srampello/AUS_KIM/README.md

# AUS_KIM

> **Sitio del robot:** [srampello.github.io/AUS_KIM](https://srampello.github.io/AUS_KIM/) · [Ficha en RMP Robotics](https://srampello.github.io/RMP/robots/aus-kim/) · [Todos los robots](https://srampello.github.io/RMP/)

Robot de laberinto **AUS_KIM** de RMP. El repositorio conserva el firmware probado de la **V1 (ESP32-S3)** y documenta la nueva **V2 (ESP32-C3 Super Mini)**.

## AUS_KIM V2 — placa nueva ESP32-C3 (en desarrollo)

**Referencia completa:** [Hardware, pinout, alimentación, conectores y validaciones de AUS_KIM V2](docs/AUS_KIM_V2_ESP32-C3.md).

La V2 incorpora:
- **ESP32-C3 Super Mini** en lugar de ESP32-S3.
- **3 sensores Sharp GP2Y0E03**: un frontal, uno lateral izquierdo y uno lateral derecho (se retira un Sharp frontal).
- **1 sensor de piso QRE1113GR** en plaqueta externa de tres contactos para detectar la llegada.
- **2 motores N20 de 1500 RPM con encoders de cuadratura completos** (dos canales A/B por motor).
- **DRV8833** con jumper JP1 en EEP/nSLEEP para habilitar los motores después del arranque.
- **Pulsador físico START** en GPIO9/BOOT, con pull-up; resistencias de 10 kΩ en GPIO2 y GPIO8.
- **LiPo 2S + BEC 5 V** para electrónica y, según el esquema, el driver de motores; masa común.

### Pinout V2 (ESP32-C3)

| GPIO | V2: función |
| ---: | --- |
| 0 | Sharp lateral izquierdo (`SH_I`) |
| 1 | Sharp frontal (`SH_F`) |
| 2 | DRV8833 IN1 (`AIN1`; motor derecho) |
| 3 | Sharp lateral derecho (`SH_D`) |
| 4 | QRE1113GR de piso (`SENSOR`) |
| 5 | Encoder izquierdo B (`ENC_IB`) |
| 6 | Encoder izquierdo A (`ENC_IA`) |
| 7 | Encoder derecho B (`ENC_DB`) |
| 8 | DRV8833 IN2 (`AIN2`; motor derecho) |
| 9 | START / BOOT (activo en LOW) |
| 10 | Encoder derecho A (`ENC_DA`) |
| 20 | DRV8833 IN3 (`BIN1`; motor izquierdo) |
| 21 | DRV8833 IN4 (`BIN2`; motor izquierdo) |

**Estado del software:** esta actualización es de documentación del hardware. El firmware existente **continúa siendo V1/ESP32-S3**: aún no está portado a ESP32-C3 ni tiene implementadas las nuevas estrategias BFS/mapeo, encoder y sensor de piso. **No cargar el firmware V1 en la nueva placa.**

### Estrategias previstas para V2

Primera pasada: explorar/mapear paredes y reconocer llegada mediante el QRE. Segunda pasada: elegir carrera con mapa y encoders o seguimiento de pared derecha. Estos modos quedan **pendientes de implementación y calibración**.

---

## AUS_KIM V1 — documentación y firmware histórico (ESP32-S3)

**Conexiones originales V1:** [docs/conexiones.md](docs/conexiones.md). Los GPIO, umbrales, motores y modo de STOP descritos a continuación pertenecen **solo a V1**.

## Hardware original de V1

- ESP32-S3 SuperMini
- 4x Sharp GP2Y0E03
- DRV8833
- 2x micro motorreductores metalicos con encoder de cuadratura
- BEC / Step-Down BLITZ 5V/12V/3A
- LiPo CNHL Pizza V2 2S, 7.4 V nominales, 250 mAh

## Etapa 01 - Diagnostico Wi-Fi

La interfaz web permite probar motores, encoders y sensores de forma independiente.

### Red

- SSID: `AUS_KIM`
- Clave: `AUSKIM2026`
- Panel: `http://192.168.4.1`

### Funciones actuales

- Control independiente de motor izquierdo y derecho.
- PWM ajustable de 0 a 255.
- ADELANTE / ATRAS mientras se mantiene presionado.
- STOP general y fail-safe.
- Lectura de encoders con canales A/B.
- Correccion izquierda/derecha de encoders solo en la interfaz.
- Seleccion manual de cual Sharp leer.
- Los otros Sharp dejan de mostrarse, pero siguen alimentados fisicamente.
- Opcion para detener la lectura de sensores.

## Pinout

### Sharp - Vout

| Sensor fisico | GPIO |
|---|---:|
| Frontal izquierdo | 2 |
| Frontal derecho | 1 |
| Lateral izquierdo | 4 |
| Lateral derecho | 3 |

### Sharp - cableado usado

Para cada GP2Y0E03:

- VDD -> 3.3 V
- Vout -> GPIO analogico correspondiente
- GND -> GND
- VIN(IO) -> 3.3 V
- GPIO1 / Pin 5 -> **sin conectar**
- SCL -> sin conectar
- SDA -> sin conectar

No se utilizan GPIO 15, 16, 17 ni 18 para los sensores.

### Motores

| Funcion fisica | GPIO |
|---|---:|
| DRV8833 IN3 motor izquierdo | 7 |
| DRV8833 IN4 motor izquierdo | 8 |
| DRV8833 IN1 motor derecho | 5 |
| DRV8833 IN2 motor derecho | 6 |

El motor fisico izquierdo requiere inversion de sentido por software.

### Encoders - cableado sin cambios

| Conexion | GPIO |
|---|---:|
| Encoder A primer par | 9 |
| Encoder B primer par | 10 |
| Encoder A segundo par | 11 |
| Encoder B segundo par | 12 |

La interfaz intercambia solamente la presentacion izquierda/derecha de esos datos.

## Seleccion manual de sensores

En el panel aparecen cuatro botones:

```text
[ SELECCIONAR Frontal izquierdo ]   [ SELECCIONAR Frontal derecho ]
[ SELECCIONAR Lateral izquierdo ]   [ SELECCIONAR Lateral derecho ]

                    [ DETENER LECTURA ]
```

Cuando se selecciona uno, el ESP32 ejecuta la lectura ADC solamente de ese canal y la interfaz muestra unicamente ese valor.

Esto **no apaga fisicamente los otros sensores**, porque el Pin 5 (GPIO1) de los Sharp no esta conectado.

## ADC y filtro de sensores

El firmware usa resolucion de 12 bits y configura atenuacion de 11 dB en los cuatro pines analogicos:

```cpp
analogReadResolution(12);
analogSetPinAttenuation(..., ADC_11db);
```

Para reducir ruido y picos se agrego un filtro de dos etapas:

1. **Mediana de 9 muestras** para rechazar lecturas aisladas.
2. **Suavizado exponencial** con 75% del valor anterior y 25% de la nueva mediana.

La interfaz muestra:

- valor grande: ADC filtrado;
- valor `Crudo`: mediana instantanea antes del suavizado.

Como cada celda del laberinto tiene un maximo de **25 x 25 cm**, durante la proxima etapa de calibracion vamos a convertir ADC a distancia y considerar cualquier lectura mayor a 25 cm como **sin pared cercana**. No se aplica todavia un corte por distancia porque primero necesitamos medir la curva real de estos sensores.

## Estructura

```text
AUS_KIM/
├── firmware/
│   └── 01_wifi_test/
│       └── AUS_KIM_WIFI_TEST.ino
├── docs/
│   └── conexiones.md
└── README.md
```

## Actualizar la copia local

```bash
git pull origin master
```

## Proximo paso

1. Validar los cuatro canales Sharp individualmente.
2. Confirmar la visualizacion correcta de ambos encoders.
3. Calibrar los Sharp con distancias conocidas.
4. Medir velocidad de ruedas.
5. Implementar PID.
6. Movimiento recto y giros.
7. Seguimiento de pared.
8. Navegacion del laberinto.

## Etapa 02 - Seguimiento de pared derecha

Se agrego:

```text
firmware/02_wall_follow/AUS_KIM_WALL_FOLLOW.ino
```

Esta version:

- usa solamente el Sharp lateral derecho;
- no usa encoders;
- mantiene una referencia inicial de ~6 cm (`ADC = 2400`);
- ejecuta el PID a 100 Hz;
- permite modificar desde la interfaz web `Kp`, `Ki`, `Kd`, objetivo ADC, PWM base, correccion maxima y umbral minimo de pared;
- muestra ADC filtrado, mediana, error, correccion y PWM de ambos motores;
- incorpora START, STOP y fail-safe por perdida de comunicacion web.

Red Wi-Fi:

- SSID: `AUS_KIM_WALL`
- Clave: `AUSKIM2026`
- Panel: `http://192.168.4.1`

Valores iniciales de prueba:

```text
Kp              = 0.12
Ki              = 0.00
Kd              = 0.35
Objetivo ADC    = 2400
PWM base        = 80
Correccion max. = 60
Pared minima    = 1500
```

La mezcla de motores es:

```text
Motor izquierdo = PWM base - correccion
Motor derecho   = PWM base + correccion
```

Como ADC alto significa pared mas cercana, una correccion positiva aleja el robot de la pared derecha.

## Etapa 04 - Maze Solver

Se agrego:

```text
firmware/04_maze_solver/AUS_KIM_MAZE_SOLVER.ino
```

Esta version implementa una navegacion tipo **regla de la mano derecha**:

1. Si detecta una apertura a la derecha, la prioriza.
2. Si encuentra pared frontal:
   - gira a la izquierda si ese lateral esta libre;
   - si tambien esta bloqueado, realiza un giro de 180 grados.
3. En recta sigue la pared derecha con PID.

Los cuatro sensores Sharp se leen en tiempo real y la interfaz muestra:

- frontal izquierdo y derecho;
- lateral izquierdo y derecho;
- ADC filtrado y crudo;
- deteccion de pared/apertura;
- estado actual del robot;
- error y correccion PID;
- PWM firmado de ambos motores;
- telemetria de ambos encoders.

Los giros son temporizados porque el encoder derecho todavia no es confiable. Desde la interfaz pueden ajustarse PID, velocidad base, correccion maxima, umbrales de sensores, PWM de giro y todos los tiempos de maniobra.

Red:

```text
SSID: AUS_KIM_MAZE
Clave: AUSKIM2026
Panel: http://192.168.4.1
```

## Etapa 05 - Test Suite unificado

Se agrego:

```text
firmware/05_test_suite/AUS_KIM_TEST_SUITE/AUS_KIM_TEST_SUITE.ino
```

Esta version concentra todas las pruebas principales en una sola interfaz web con tres pestañas:

1. **Sensores / Motores / Encoders**
   - lectura en vivo de los 4 Sharp;
   - valor filtrado y crudo;
   - prueba manual independiente de cada motor;
   - PWM manual;
   - lectura de encoders y estados A/B;
   - reset de encoders.

2. **PID pared derecha**
   - seguimiento de pared derecha;
   - ajuste en vivo de Kp, Ki y Kd;
   - objetivo ADC;
   - PWM base;
   - correccion maxima;
   - telemetria de sensores, motores, error y correccion.

3. **Resolver laberinto**
   - regla de la mano derecha;
   - deteccion frontal;
   - deteccion de aperturas laterales;
   - giro derecha, izquierda y 180 grados;
   - ajuste en vivo de umbrales, PWM y tiempos de maniobra;
   - telemetria completa.

Los encoders siguen siendo solo de diagnostico y no intervienen en el PID ni en los giros.

Red Wi-Fi:

```text
SSID: AUS_KIM_TEST
Clave: AUSKIM2026
Panel: http://192.168.4.1
```

Al cambiar de pestaña/modo, el firmware detiene los motores por seguridad. Tambien mantiene un fail-safe de comunicacion web.

### Logo RMP separado del firmware

El logo se guarda como `rmp_logo.h` junto al sketch, usando Base64 en memoria de programa (`PROGMEM`). Esto elimina las miles de lineas de imagen incrustada del `.ino` sin perder el funcionamiento offline.

```text
firmware/
├── 05_test_suite/AUS_KIM_TEST_SUITE/
│   ├── AUS_KIM_TEST_SUITE.ino
│   └── rmp_logo.h             # Fuente del logo
└── 06_race/AUS_KIM_RACE/
    ├── AUS_KIM_RACE.ino       # Generado automaticamente
    └── rmp_logo.h             # Copia sincronizada
```

Arduino requiere que cada archivo `.ino` este dentro de una carpeta con el mismo nombre. El archivo `.h` tiene que permanecer al lado del `.ino` correspondiente. La pagina solicita el logo al propio ESP32 mediante `/api/rmp-logo-b64`, sin necesitar Internet.

Si se cambia el logo del Test Suite, GitHub Actions sincroniza tambien `rmp_logo.h` de carrera. El logo NO se edita directamente dentro de los archivos generados.

## Etapa 06 - Race Control RMP (largada)

Dos interfaces, **un solo codigo de navegacion**:

- Test Suite: `firmware/05_test_suite/AUS_KIM_TEST_SUITE/AUS_KIM_TEST_SUITE.ino`
  - `http://192.168.4.1/`: interfaz de calibracion y pruebas.
  - `http://192.168.4.1/race`: interfaz sencilla de carrera RMP.
- Race: `firmware/06_race/AUS_KIM_RACE/AUS_KIM_RACE.ino`
  - `http://192.168.4.1/`: interfaz de carrera RMP como pantalla principal.
  - El boton circular central con logo **RMP** inicia `MODE_MAZE`.
  - El boton **STOP** detiene los motores.

En ambos firmwares se usa la misma red `AUS_KIM_TEST`, clave `AUSKIM2026`.

### Sincronizacion automatica

**Siempre modificar el Test Suite**: es la unica fuente del programa. El firmware Race es generado y NO se debe editar a mano.

Cada push que modifique el `.ino` del Test Suite ejecuta el workflow:
`.github/workflows/sincronizar_race.yml`.

El workflow regenera el `.ino` de carrera mediante `tools/generar_aus_kim_race.py` y guarda los cambios automaticamente en GitHub.

Tambien se puede regenerar localmente desde la raiz del repositorio:

```bash
python tools/generar_aus_kim_race.py
```

Esto asegura que Race tenga el ultimo PID de pared, deteccion de sensores, manejo de encoders, giros y calibraciones **definidas en el codigo** del Test Suite. Los ajustes hechos solo en los formularios web son temporales en RAM: para pasarlos al firmware de carrera hay que actualizar sus valores iniciales en el Test Suite y subir el cambio a GitHub. Generar o actualizar el archivo de GitHub NO reprograma automaticamente el ESP32-S3: volver a cargar el `.ino` de carrera cuando se modifique el programa.

**Seguridad:** el firmware conserva el boton STOP y el corte automatico si pierde la conexion con la pagina web; mantener la pagina abierta durante la carrera.

### Navegacion reversible: pared derecha / pared izquierda

El **Test Suite** y el **Race Control** tienen dos pestañas para seleccionar la estrategia antes de iniciar. Una sola maquina de estados contiene las maniobras, compartiendo los encoders y tiempos.

| Estrategia | Sensor para PID | Apertura prioritaria | Giro con obstaculo frontal |
| --- | --- | --- | --- |
| Pared derecha (`MAZE`) | Sharp lateral derecho | Derecha | Izquierda |
| Pared izquierda (`MAZE_LEFT`) | Sharp lateral izquierdo | Izquierda | Derecha |

Al detectar una apertura en el lado seleccionado, el robot frena **500 ms**, avanza **3 cm** con compensacion por encoders, espera **300 ms**, gira 90 grados hacia la apertura y espera otros **300 ms**. En ambas estrategias se aplica la misma regla de continuar buscando salida si el frente sigue bloqueado. Se conservan el STOP manual y los limites de seguridad.

La pestaña **PID pared lateral** del Test Suite permite iniciar `WALL` o `WALL_LEFT`, con calibraciones separadas:
- Derecha: `kp`, `ki`, `kd`, `targetRightAdc`.
- Izquierda: `leftKp`, `leftKi`, `leftKd`, `targetLeftAdc`.
- Aperturas: `rightOpenAdc` y `leftOpenAdc`.

Los valores de izquierda comienzan iguales a los de derecha solo como punto de partida: hay que calibrarlos en pista. El modo de carrera muestra ambas pestañas, el logo RMP central, el boton LARGAR y el STOP; el cambio de lado se bloquea mientras corre. El Test Suite conserva sus pruebas y parametros.

**Importante:** los cambios realizados desde la pagina web no se graban en memoria persistente; para fijar una calibracion de competencia, modificar los valores predeterminados del Test Suite en GitHub y volver a cargar el firmware. La sincronizacion por GitHub Actions regenera `AUS_KIM_RACE.ino` automaticamente.

### Interfaces web separadas del firmware

Desde esta refactorizacion **no hay HTML incrustado en los archivos .ino**. Se usan encabezados locales con cadenas HTML en `PROGMEM`, para conservar el servidor Wi-Fi sin LittleFS ni carga adicional de archivos.

```text
firmware/
├── 05_test_suite/AUS_KIM_TEST_SUITE/
│   ├── AUS_KIM_TEST_SUITE.ino   # Motores, sensores, encoders, PID, Maze y API
│   ├── web_test_suite.h         # HTML/CSS/JS de pruebas y calibracion
│   ├── web_race.h               # HTML/CSS/JS de largada RMP
│   └── rmp_logo.h               # Logo RMP en memoria flash
└── 06_race/AUS_KIM_RACE/
    ├── AUS_KIM_RACE.ino         # Generado automaticamente desde Test Suite
    ├── web_test_suite.h         # Copia generada
    ├── web_race.h               # Copia generada
    └── rmp_logo.h               # Copia generada
```

**Fuente de verdad:** editar el `.ino` y los archivos `.h` del directorio `05_test_suite`. Nunca modificar manualmente los archivos de `06_race`.

El script `python tools/generar_aus_kim_race.py` genera el `.ino` Race y sincroniza los tres `.h`. GitHub Actions realiza ese proceso al modificar cualquiera de estos archivos fuente. Ambos sketches deben compilarse con los tres encabezados en la misma carpeta que su correspondiente `.ino`.

Rutas web:
- Test Suite: `http://192.168.4.1/`
- Vista de carrera desde Test Suite: `http://192.168.4.1/race`
- En el firmware Race, la vista de carrera aparece en la ruta `/`.

El cambio solo reorganiza los archivos de interfaz y no modifica los parametros de navegacion ni la logica del robot.

## Navegacion actual: sin encoders en modo autonomo (octubre de 2026)

El seguimiento de pared derecha e izquierda usa los sensores Sharp y PID. Al detectar pared frontal, frena **300 ms** y gira hacia el lado contrario a la pared elegida: izquierda si sigue la derecha, o derecha si sigue la izquierda. Despues espera **300 ms**, vuelve a leer los sensores y repite si el frente continua bloqueado.

Cuando detecta una apertura del lado elegido, primero espera **500 ms**, avanza una distancia **aproximada** por tiempo (no con encoders), espera **300 ms**, gira hacia esa apertura y espera otros **300 ms** antes de retomar el PID.

Los encoders **ya no participan en ninguna decision, avance ni giro de los modos MAZE y MAZE_LEFT**. Permanecen en la pestana de diagnostico por si se desea revisarlos mas adelante.

### Calibracion de maniobras temporizadas

| Parametro API | Inicial | Descripcion |
| --- | ---: | --- |
| `openingAdvanceMs` | 100 ms | Duracion del avance corto; ajustar para acercarse a 3 cm |
| `openingLeftPwm` | 180 | PWM del motor izquierdo en avance corto / sin pared |
| `openingRightPwm` | 180 | PWM del motor derecho en avance corto / sin pared |
| `turn90LeftMs` | 160 ms | Giro izquierdo aproximado de 90 grados |
| `turn90RightMs` | 160 ms | Giro derecho aproximado de 90 grados |
| `turnPwm` | 180 | PWM para ambos sentidos de giro |

Estos son **valores conservadores de prueba, no mediciones calibradas**. Como los motores tienen distinta respuesta, no se garantiza que el avance sea de 3 cm ni que los giros sean de 90 grados hasta medirlos fisicamente. El Test Suite ahora permite probar por separado **avance corto**, **giro izquierdo** y **giro derecho** desde Resolver laberinto, sin necesidad de ejecutar el recorrido completo. Las pruebas utilizan `/api/timed_test` y se detienen automaticamente al completar la duracion. Calibrar inicialmente con el robot en espacio despejado y usar STOP ante cualquier desvio.

El boton STOP y el corte por perdida de comunicacion Wi-Fi permanecen activos. Las configuraciones modificadas en la interfaz son temporales (RAM); para grabarlas de manera permanente, hay que cambiar los valores iniciales en el Test Suite y volver a cargar el firmware. El firmware de carrera se genera desde el Test Suite mediante el workflow de GitHub Actions.

## Configuracion de carrera vigente: siempre pared derecha (10/10/2026)

El firmware **AUS_KIM_RACE** inicia exclusivamente el modo `MAZE` (regla de mano derecha). El Test Suite conserva la variante izquierda solo para experimentacion y calibracion.

- PWM base de avance: **165**, con un minimo de **155** PWM para evitar bloqueo de los motores.
- Obstaculo frontal: ambos sensores Sharp deben confirmar **ADC >= 1650** durante varias muestras.
- Apertura lateral derecha: **ADC < 1750**, confirmada y prioritaria frente a la pared frontal.
- En una apertura derecha: parar **500 ms**, avanzar un tramo objetivo de **15 cm** sin encoders, esperar **300 ms**, girar a la derecha durante el tiempo calibrado y esperar **300 ms**.
- Tiempo inicial del avance: **500 ms** a PWM izquierdo/derecho **165**. **ESTE VALOR NO ESTA CALIBRADO** y no equivale necesariamente a 15 cm. Se ajusta desde Test Suite con `openingAdvanceMs`, `openingLeftPwm` y `openingRightPwm`.
- Ante pared frontal **sin** salida derecha confirmada: frenar, esperar `decisionWaitMs` y girar a izquierda. Si hay una salida derecha confirmada, no elegir izquierda.
- Si aparece una pared frontal mientras realiza el avance de la apertura, el robot interrumpe inmediatamente el avance largo y prepara el giro hacia la salida elegida para evitar continuar de frente.
- La navegacion sigue sin encoders; los tiempos de giro izquierdo/derecho permanecen configurables. No se han modificado sus calibraciones.
- STOP manual y corte por perdida de comunicacion Wi-Fi permanecen activos.

La pestaña Resolver laberinto del Test Suite muestra los nuevos umbrales y permite calibrar el avance de 15 cm aproximados sin necesidad de hacer una carrera completa. Los valores actualizados mediante navegador son temporales hasta grabar el firmware.

## Carrera autonoma aun sin Wi-Fi

El firmware distingue dos tipos de movimiento:

- **Carrera RMP**: al pulsar el logo **LARGAR** en la interfaz `/race` (o `/` en el firmware Race), el navegador envia `/api/mode?mode=MAZE` y luego `/api/run?state=1&autonomous=1`. El ESP32-S3 sigue ejecutando el laberinto localmente si se desconecta el celular o se interrumpe el heartbeat Wi-Fi.
- **Test Suite (pruebas, PID, motores, encoders y largada de pruebas)**: permanece activo el corte de motores por falta de heartbeat durante **1500 ms**, para que las pruebas supervisadas no queden descontroladas si se pierde el navegador.

La carrera autonoma **NO elimina las paradas locales**:
- **STOP fisico**: `GPIO0`, configurado con `INPUT_PULLUP`, activo al conectarlo a GND (35 ms de antirrebote). En placas que conectan el boton BOOT a GPIO0, se puede utilizar ese boton. **Comprobar el conexionado real de esta variante ESP32-S3 SuperMini, el acceso al boton y su funcionamiento con el robot elevado antes de competir.**
- **Limite maximo de carrera**: 120 segundos a partir de la largada; se detienen los motores aunque no haya Wi-Fi.
- **STOP remoto**: `/api/stop` sigue funcionando mientras exista conexion. Si se pierde el Wi-Fi, el telefono **ya no sirve como control de emergencia**: usar el boton local probado o desconectar fisicamente la alimentacion.
- Los sensores Sharp siguen frenando ante pared frontal durante los avances, y la navegacion conserva el algoritmo de pared derecha.

El estado `/api/status` expone `autonomousRace` y `raceElapsedMs`. La pantalla Race informa que puede seguir corriendo sin Wi-Fi. **No arrancar una carrera autonoma hasta haber comprobado una parada local confiable**. Presionar GPIO0 al reiniciar puede poner el ESP32-S3 en modo descarga; por eso el boton se utiliza como parada durante la ejecucion, no manteniendolo presionado al encender.

Solo el modo `MAZE` permite `autonomous=1`. El cambio esta disponible en Test Suite y Race porque el firmware Race se genera a partir del Test Suite y sincroniza sus archivos `.h`.

## Nueva estrategia simple: curvas abiertas (10/10/2026)

Tras las pruebas en pista, **Race siempre sigue pared derecha**. Se reemplazo la maquina de estados anterior (freno de 500 ms + avance de 15 cm + giro sobre su eje) por un ciclo corto:

1. **Seguir la pared derecha** con el PID y PWM 165.
2. Si se confirma apertura derecha (ADC menor a 1750), entrar apenas en la esquina durante `cornerEntryMs` (inicial 100 ms) y **girar a la derecha con curva abierta**: rueda izquierda hacia adelante, rueda derecha quieta. Si aparece pared frontal durante la entrada, dejar de avanzar recto y comenzar el giro.
3. Ante pared frontal (dos Sharp confirmando ADC >= 1650) **sin salida derecha**, frenar y girar a la izquierda con curva abierta: rueda derecha hacia adelante, rueda izquierda quieta.
4. Tras el giro, esperar 100 ms, volver a leer sensores y continuar buscando la pared derecha.

**Se conservan exactamente las calibraciones del commit del usuario `cambio valores girar ms`:** `turn90RightMs = 166`, `turn90LeftMs = 174`, `turnPwm = 180` y `openingAdvanceMs = 650`. Los tiempos de giro originales fueron medidos sobre el eje (motores en sentidos contrarios). Para la nueva curva abierta, el firmware calcula la duracion `turn90RightMs * openTurnRightFactor` y `turn90LeftMs * openTurnLeftFactor`, factores iniciales 2.0. Asi, **332 ms derecha y 348 ms izquierda son estimaciones**, no mediciones de 90 grados en giro abierto.

En Test Suite > Resolver laberinto hay botones para probar **curva abierta derecha e izquierda** de manera independiente, ademas de los ajustes `openTurnRightFactor`, `openTurnLeftFactor` y `cornerEntryMs`. Calibrar primero los giros con el robot en un espacio despejado. La prueba recta de 650 ms permanece disponible solo para diagnostico: el algoritmo Maze ya no la utiliza. Los encoders siguen excluidos del control autonomo.

**Seguridad:** frenado frontal, STOP remoto, STOP fisico GPIO0 y limite de carrera autonoma de 120 segundos conservados. Si se pierde Wi-Fi, el modo Race continua, por lo que la parada local debe estar comprobada antes de competir.

La variante por pared izquierda sigue disponible en el Test Suite para experimentacion y utiliza las maniobras espejadas. Esta es una simplificacion heuristica del seguimiento de pared; no se garantiza resolver cualquier laberinto ni girar exactamente 90 grados sin calibracion real.

## Estrategia activa: perdida confirmada de pared derecha (10/10/2026)

Esta seccion **reemplaza las estrategias anteriores de apertura ADC1750, avance de 15 cm y giros abiertos predeterminados** descritas mas arriba. Es la configuracion vigente de Race:

1. Seguir exclusivamente pared derecha con PID, PWM base **165** y objetivo lateral derecho **2300 ADC**.
2. **No girar por apertura a 1750**. El Sharp derecho solo declara perdida si su lectura filtrada permanece estrictamente **por debajo de 1300 durante 100 ms continuos**. Si vuelve a **1300 o mas** antes de ese tiempo, el conteo se cancela y vuelve a cero.
3. Durante estos primeros 100 ms sin pared, seguir **recto** con PWM independiente 165/165; el PID queda temporalmente suspendido para evitar una correccion violenta al detectar espacio libre.
4. Tras confirmar la perdida, avanzar recto otros **150 ms** para despejar el vertice de la esquina. Si vuelve a ver pared con ADC >=1500 durante tres muestras de control consecutivas, retomar el PID inmediatamente.
5. Si no recupera pared, buscarla hacia la derecha con una **curva amplia**, manteniendo las dos ruedas hacia adelante: PWM exterior/izquierdo 195 e interior/derecho 155. Al volver a confirmar pared (ADC >=1500), retomar PID derecho.
6. Frente bloqueado (ambos Sharp frontales ADC >=1650, confirmados) tiene prioridad incluso mientras busca o despeja la esquina: detenerse, esperar 300 ms y **girar a izquierda sobre su eje durante 174 ms**; luego reanudar seguimiento de pared derecha.

No se usan encoders en el modo autonomo y no se realizan giros a derecha sobre el eje para buscar pared. Se conserva la calibracion de 166 ms derecha para pruebas de diagnostico, pero no se usa en Maze. La opcion Maze por izquierda quedo deshabilitada; el PID lateral izquierdo sigue disponible solo como prueba.

| Parametro de `/api/config` | Predeterminado |
| --- | ---: |
| `rightLostAdc` | 1300 |
| `rightLostConfirmMs` | 100 ms |
| `rightRecoverAdc` | 1500 |
| `rightClearanceMs` | 150 ms |
| `searchRightOuterPwm` | 195 |
| `searchRightInnerPwm` | 155 |
| `turn90LeftMs` | 174 ms |

El Test Suite permite regular estos valores y muestra `rightLossElapsedMs` para facilitar la observacion. Las modificaciones del navegador permanecen en RAM hasta actualizar los valores por defecto en el firmware y volver a grabarlo. Como no contamos con medicion absoluta de posicion, **los 150 ms y el radio de busqueda requieren pruebas fisicas en un tramo con esquina**. El tiempo de carrera de 120 s, STOP local BOOT/GPIO0 y STOP web al estar conectado siguen activos.
