srampello/AUS_KIM/cad/PLANTILLA_CELDA_vista.png

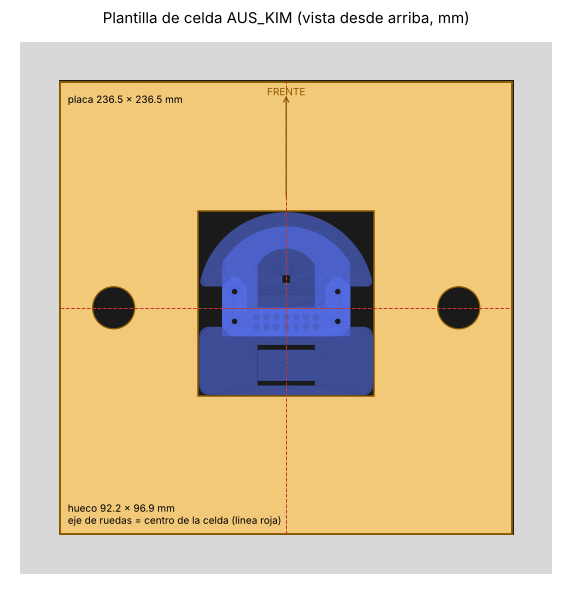
cad/PLANTILLA_CELDA_vista.png
