srampello/AUS_KIM/docs/img/etapas/etapa1_bateria_vbat.png

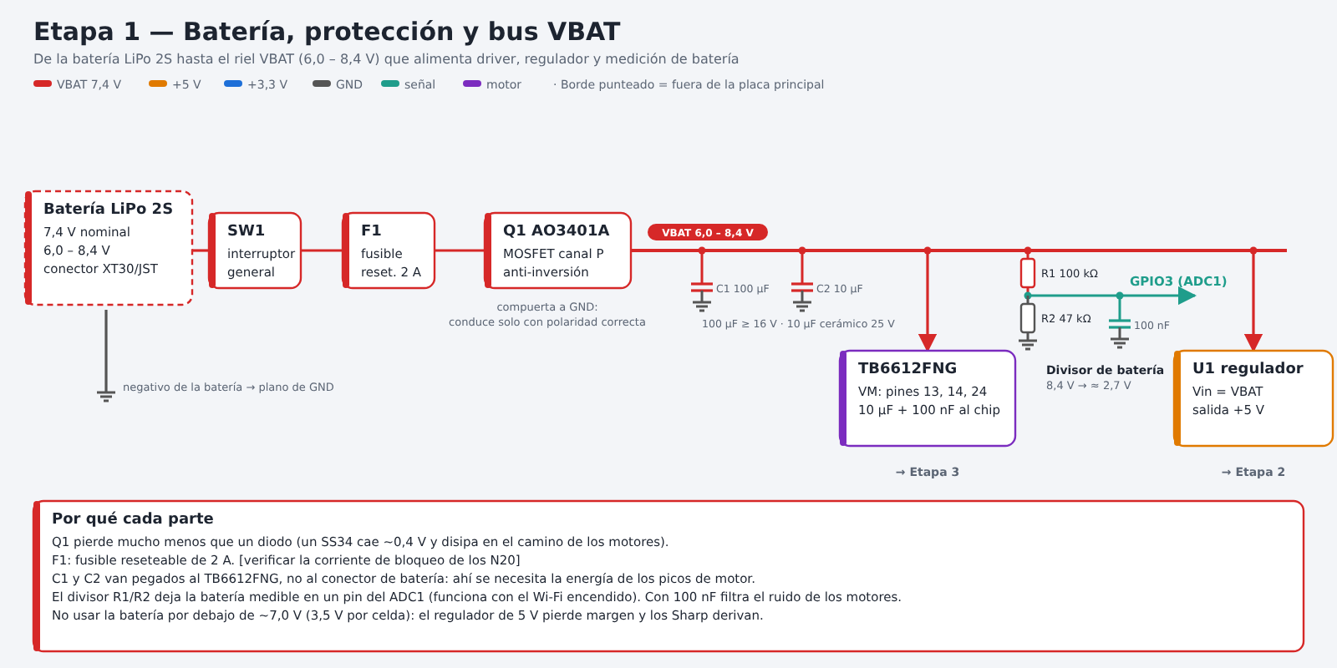
docs/img/etapas/etapa1_bateria_vbat.png
