srampello/AUS_KIM/docs/img/etapas/etapa2_regulador_5v_3v3.png

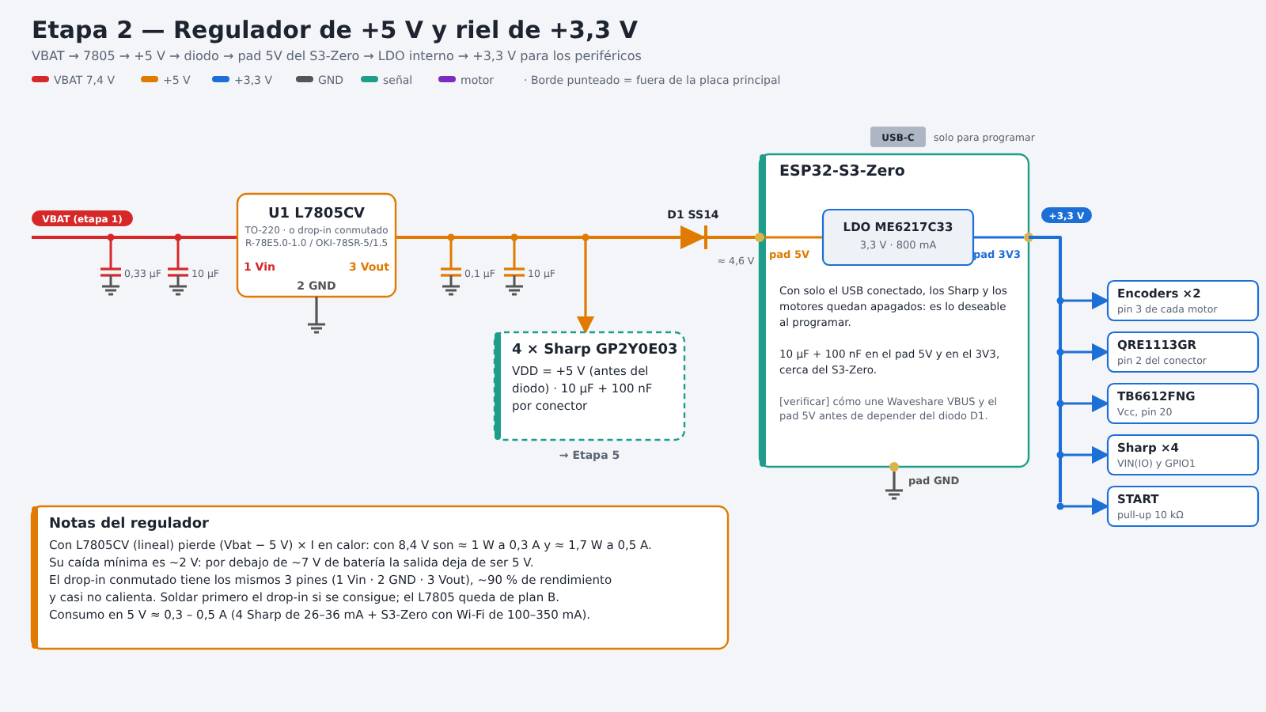
docs/img/etapas/etapa2_regulador_5v_3v3.png
