srampello/AUS_KIM/docs/img/etapas/etapa3_driver_tb6612fng.png

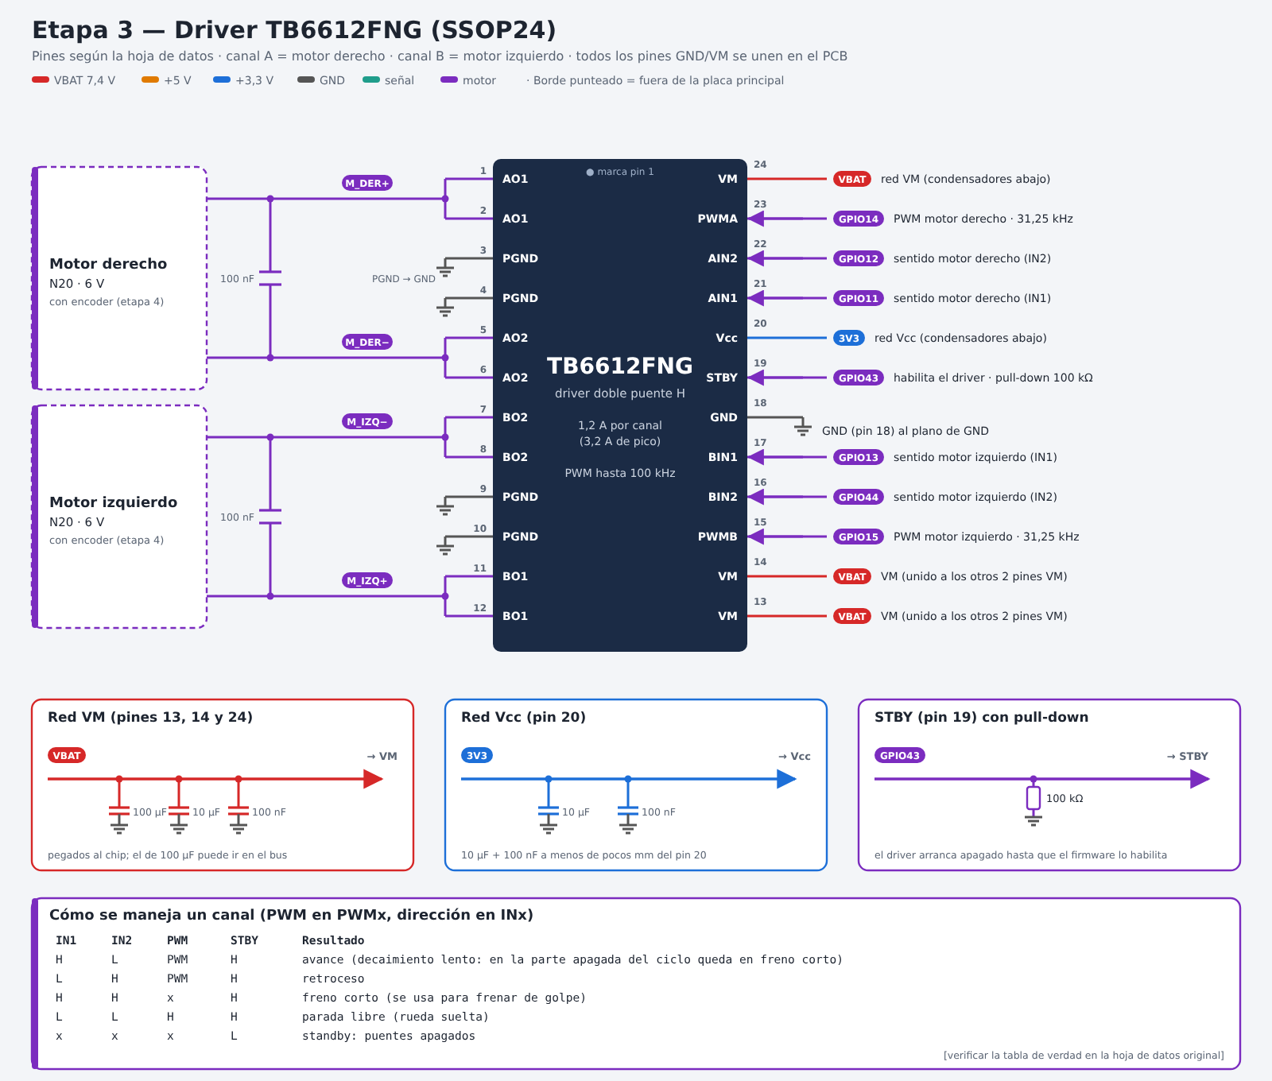
docs/img/etapas/etapa3_driver_tb6612fng.png
