srampello/AUS_KIM/docs/img/etapas/etapa4_motores_encoders.png

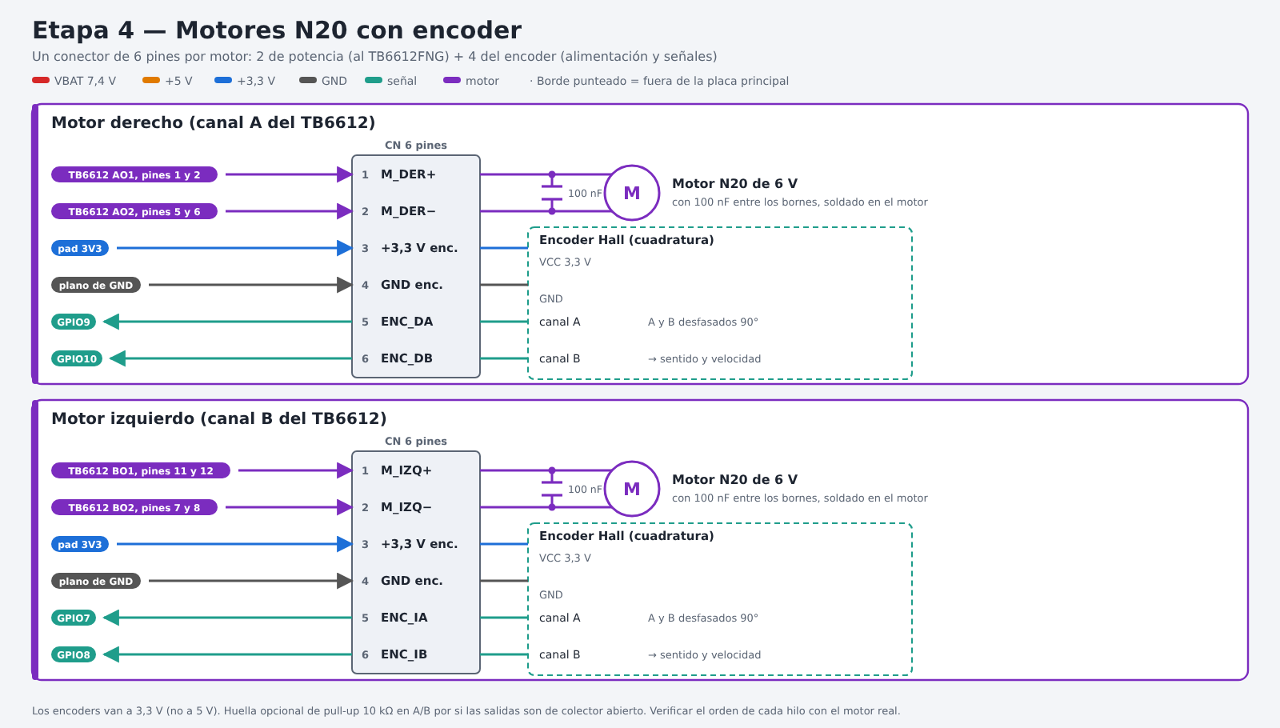
docs/img/etapas/etapa4_motores_encoders.png
