srampello/AUS_KIM/docs/img/etapas/etapa5_sensores_sharp.png

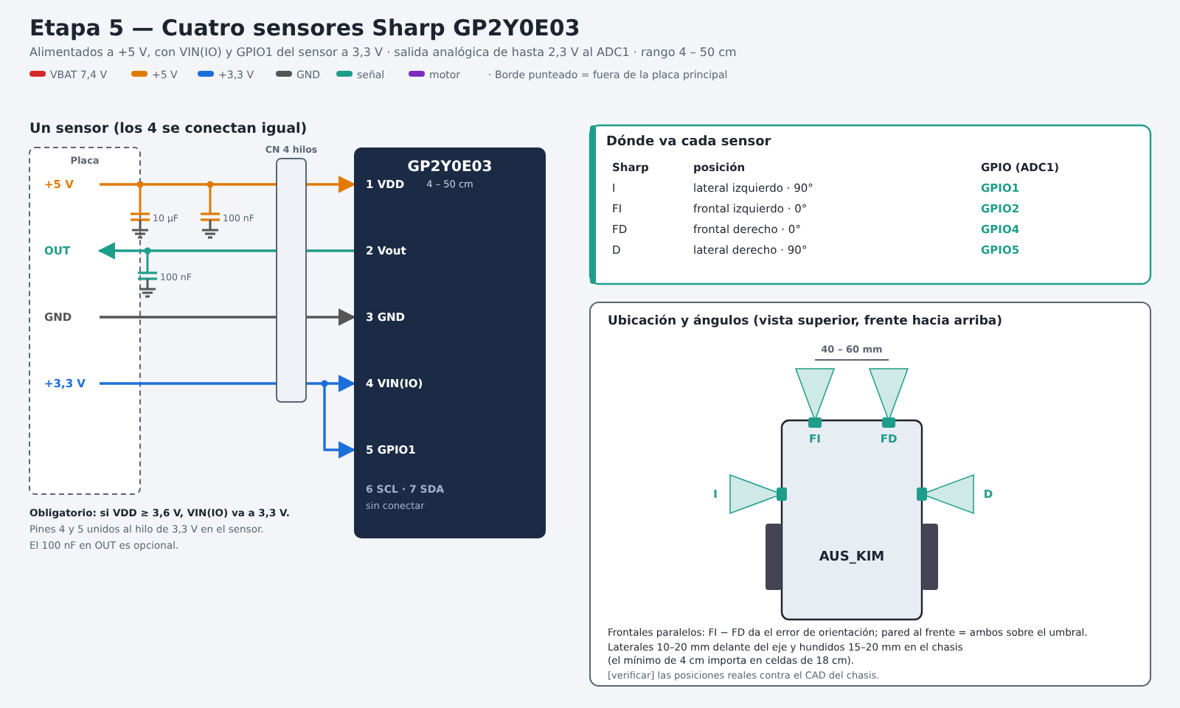
docs/img/etapas/etapa5_sensores_sharp.png
