srampello/AUS_KIM/docs/img/etapas/etapa6_qre_start.png

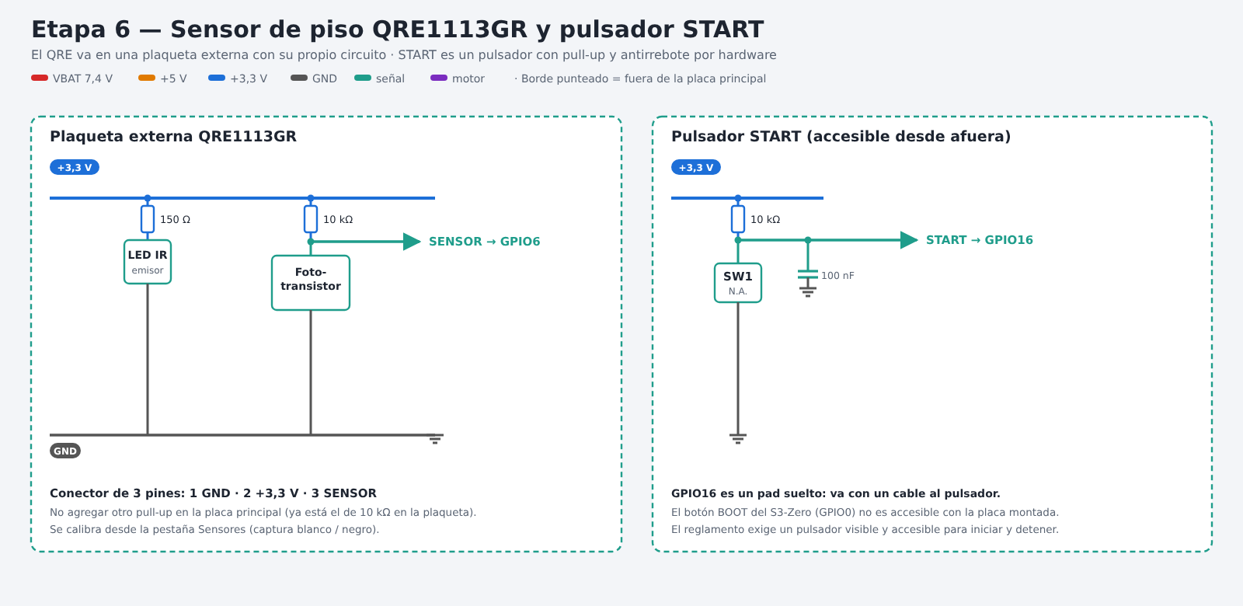
docs/img/etapas/etapa6_qre_start.png
