srampello/AUS_KIM/docs/img/etapas/etapa7_mapa_pines_s3.png

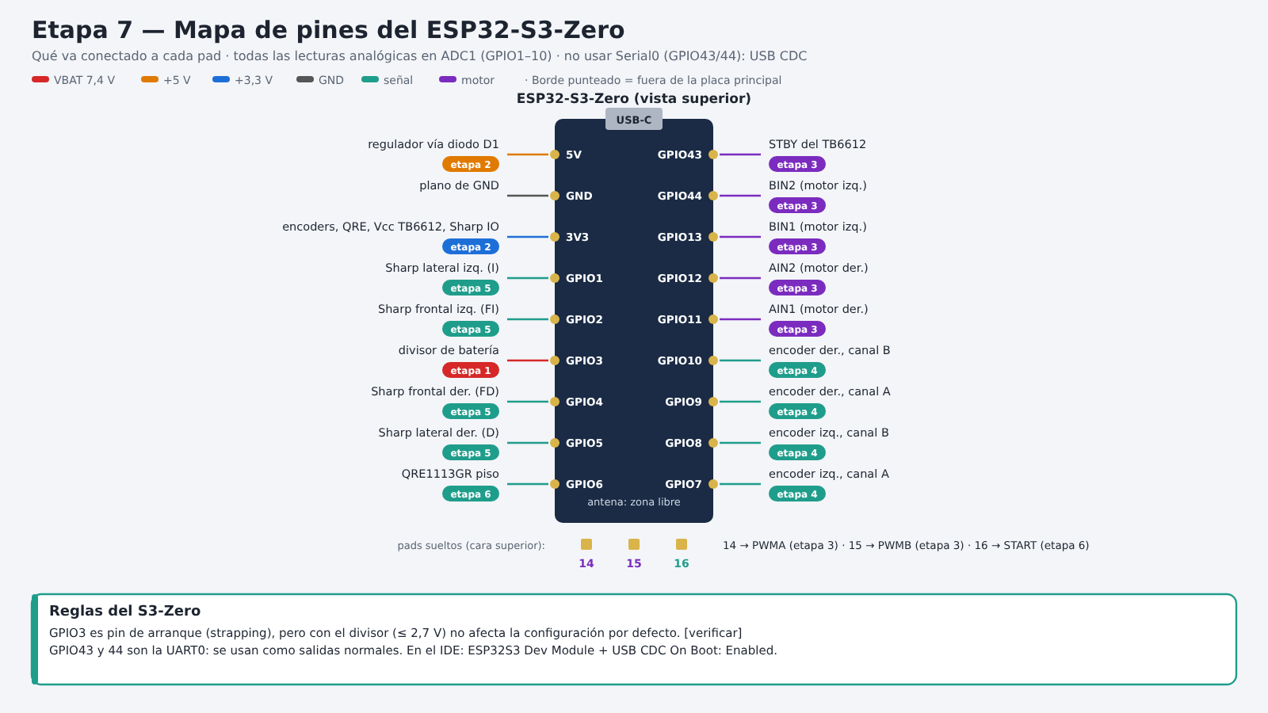
docs/img/etapas/etapa7_mapa_pines_s3.png
