srampello/AUS_KIM/images/AUS_KIM.jpeg

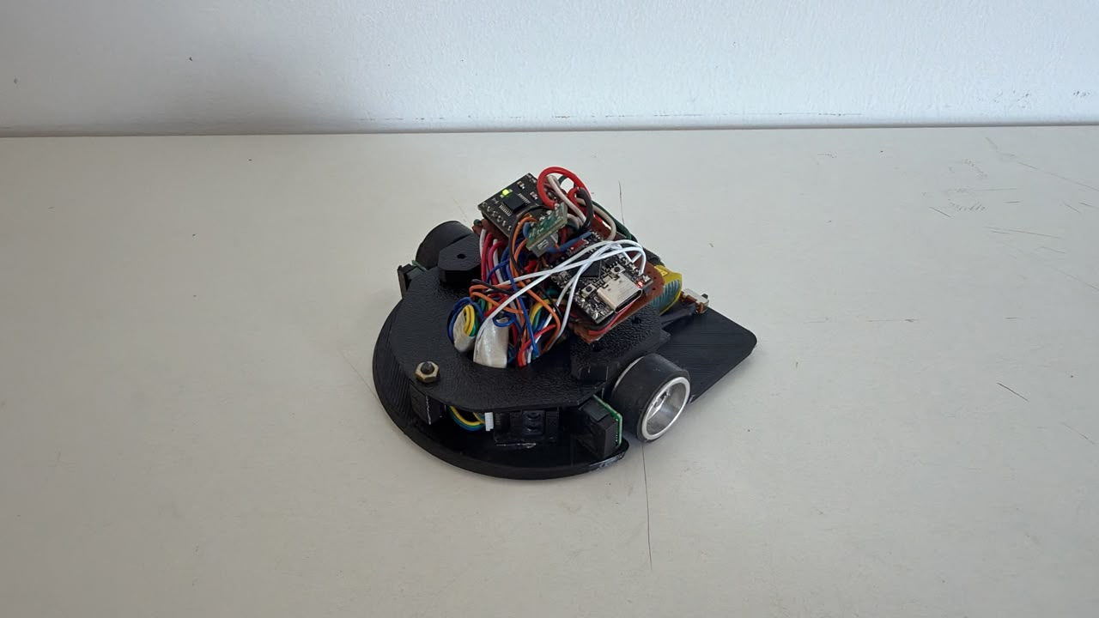
images/AUS_KIM.jpeg
