srampello/AUS_KIM/images/AUS_KIM.png

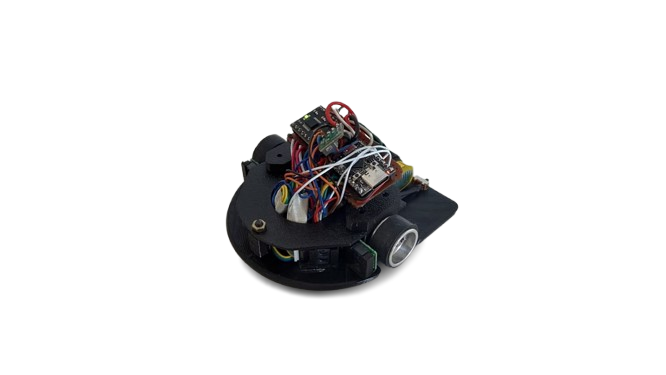
images/AUS_KIM.png
