srampello/AUS_KIM/cad/PLANTILLA_CELDA.dxf

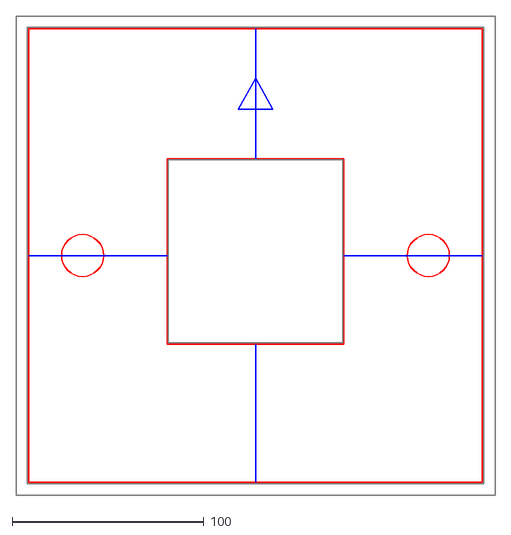
[picture p12: CAD file, 2026-10-29]
cad/PLANTILLA_CELDA.dxf
250.0 x 250.0
