srampello/AUS_KIM/stl/AUS_KIM_top.stl

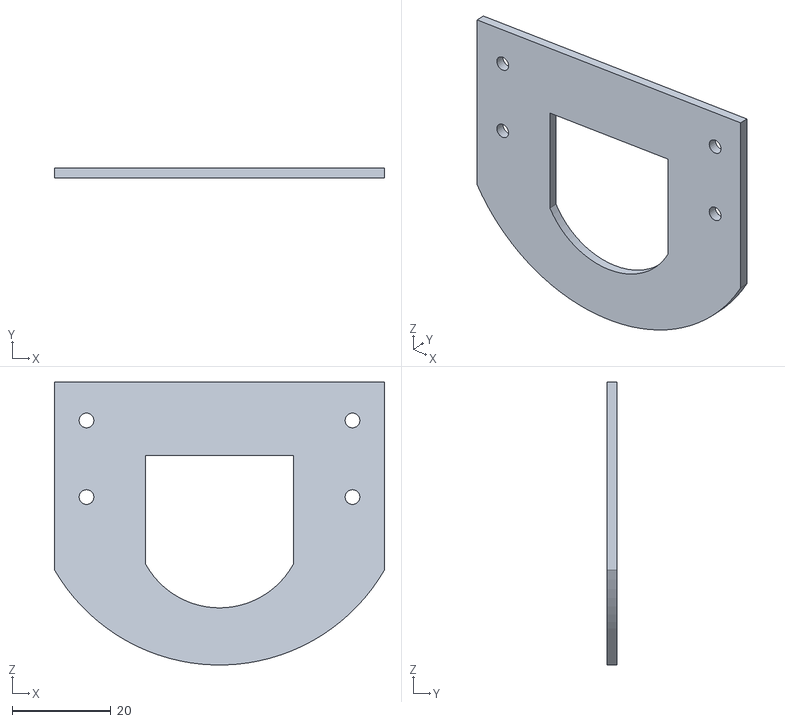
[picture p13: CAD file, 2026-10-29]
stl/AUS_KIM_top.stl
67.0 x 2.00 x 57.4
