srampello/AUS_KIM/stl/AUS_KIM_BASE.stl

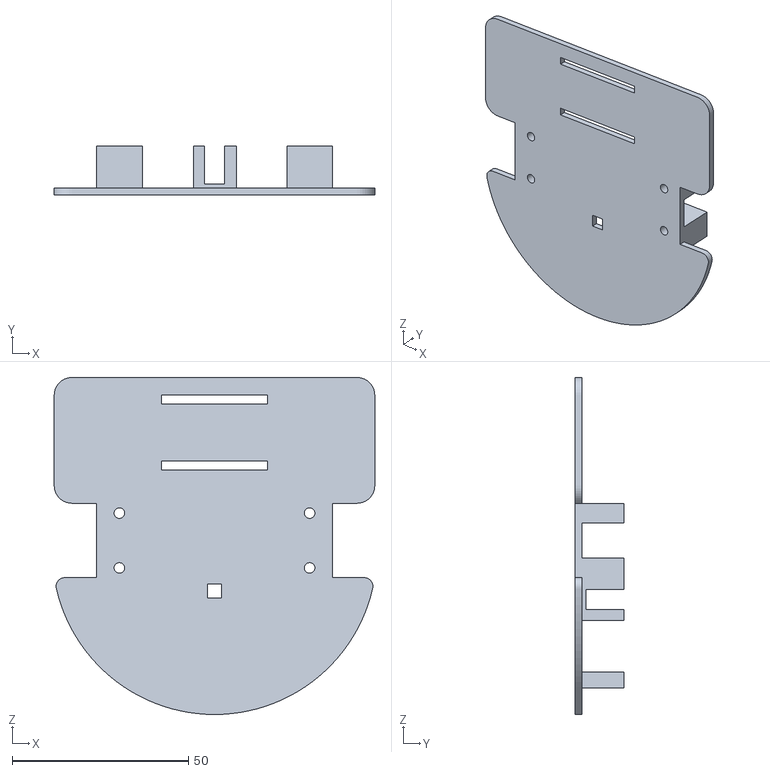
[picture p14: CAD file, 2026-10-29]
stl/AUS_KIM_BASE.stl
91.0 x 14.0 x 95.7
