srampello/AUS_KIM/stl/base_sharp.stl

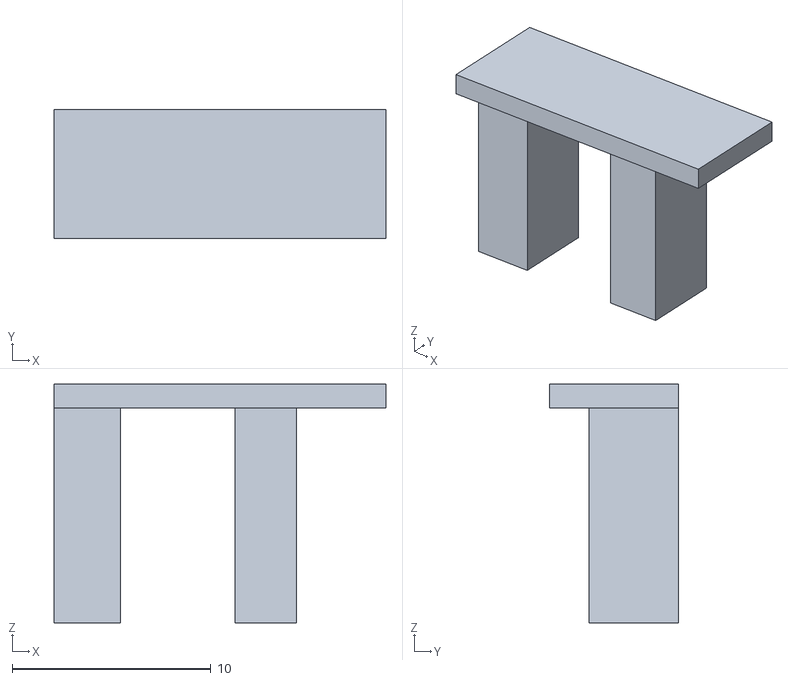
[picture p15: CAD file, 2026-09-30]
stl/base_sharp.stl
16.7 x 6.50 x 12.0
