srampello/AUS_KIM/stl/AUS_KIM_soporteplaqueta.stl

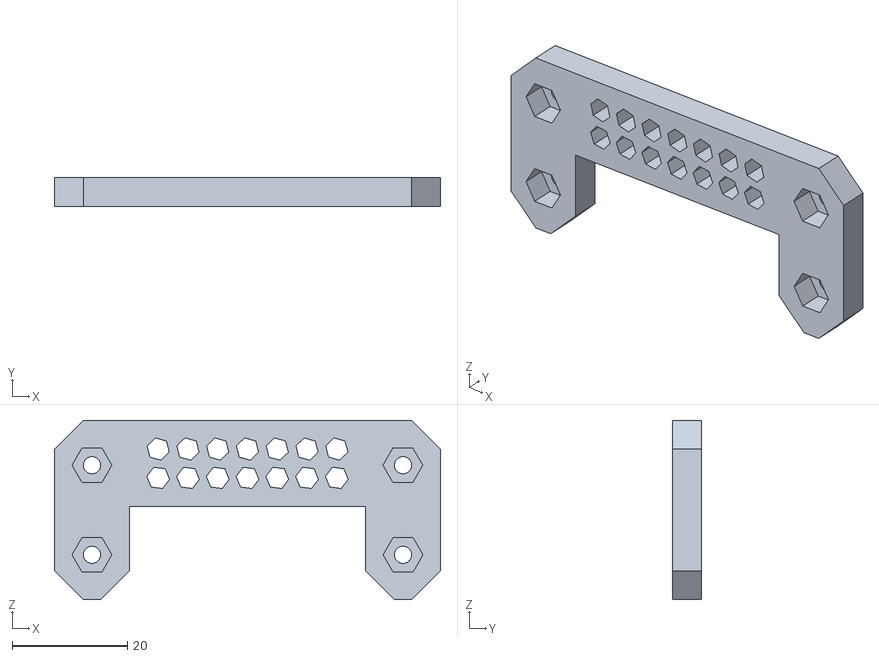
[picture p16: CAD file, 2026-09-30]
stl/AUS_KIM_soporteplaqueta.stl
67.0 x 5.00 x 31.2
