srampello/AUS_KIM/(list of files, cad)

Other CAD files:
stl/AUS_KIM.stl
