srampello/AUS_KIM/EasyEDA/KIM_Board.pdf

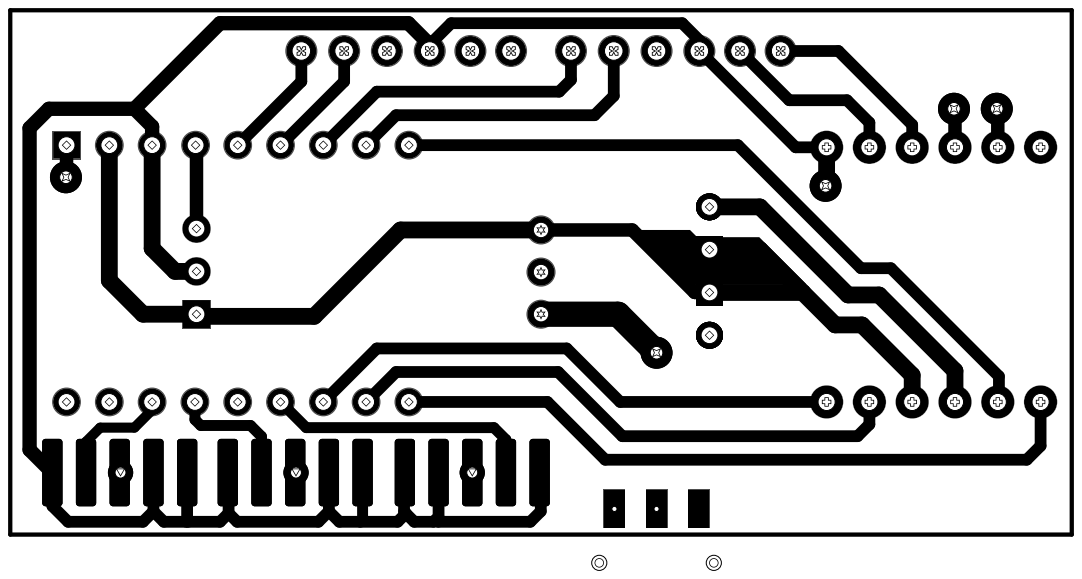
[picture p17: page 1]
