srampello/AUS_KIM/EasyEDA/PCB_KIM_BOTTOM.pdf

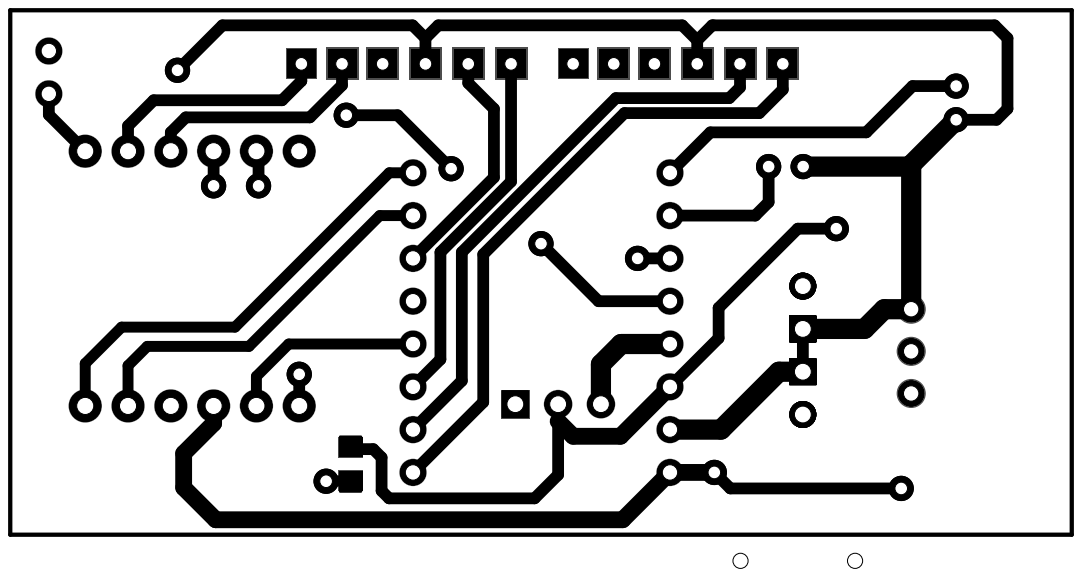
[picture p18: page 1]
