srampello/AUS_KIM/EasyEDA/PCB_KIM_TOP.pdf

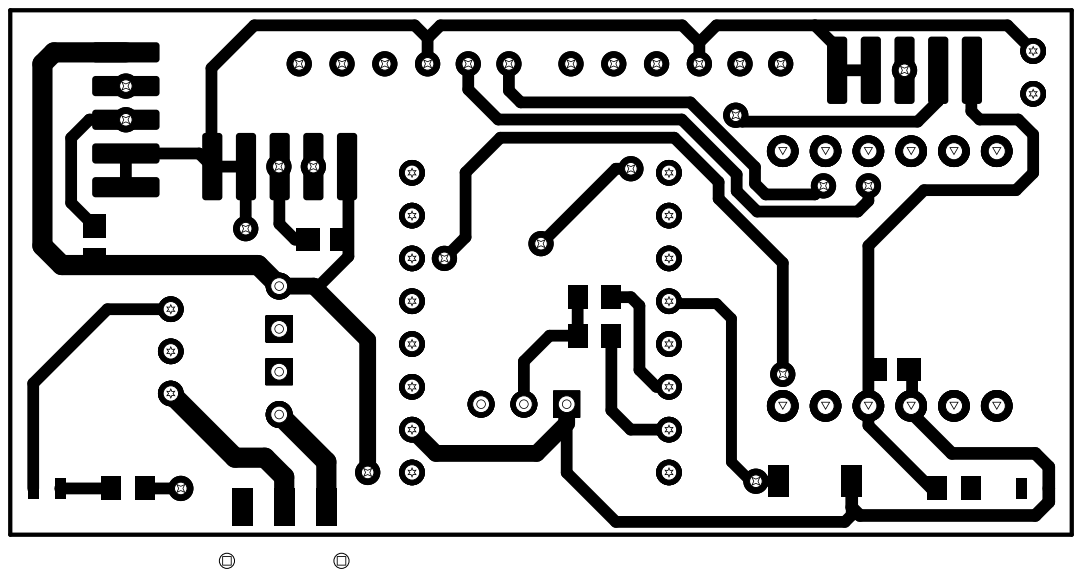
[picture p19: page 1]
