srampello/AUS_KIM/(commit log)

2026-09-23 Agregar firmware inicial de diagnostico Wi-Fi
2026-09-23 Documentar conexiones actuales de AUS_KIM
2026-09-23 Actualizar README con etapa de diagnostico Wi-Fi
2026-09-23 Corregir lados de motores y sensores segun prueba fisica
2026-09-23 Corregir pinout verificado de AUS_KIM
2026-09-23 Corregir mapeo fisico de motores y sensores
2026-09-23 Documentar cableado verificado y estado de encoders
2026-09-23 Actualizar README con pinout verificado y estado de pruebas
2026-09-23 Activar sensores de a uno y corregir lados de encoders
2026-09-23 Documentar activacion secuencial de sensores y encoders corregidos
2026-09-23 Actualizar pinout y activacion individual de sensores
2026-09-23 Agregar seleccion manual de sensores y corregir encoders solo en interfaz
2026-09-23 Aclarar seleccion manual de sensores y correccion visual de encoders
2026-09-23 Actualizar README con seleccion manual de sensores
2026-09-24 Corregir declaracion MotorDir para compilacion en Arduino IDE
2026-09-24 Adaptar seleccion de sensores al cableado real sin pin 5
2026-09-24 Corregir documentacion de sensores sin pin 5
2026-09-24 Actualizar README al cableado real de los Sharp
2026-09-24 Agregar filtro de mediana y suavizado a sensores Sharp
2026-09-24 Documentar filtro de sensores y rango util del laberinto
2026-09-24 Documentar filtro de sensores
2026-09-26 Agregar seguimiento de pared derecha con PID ajustable por WiFi
2026-09-26 Documentar etapa 02 de seguimiento de pared derecha
2026-09-27 Agregar telemetria de encoders al seguimiento de pared
2026-09-27 Corregir lado y sentido de encoders en telemetria
2026-09-27 Agregar prueba PID para mantener distancia frontal
2026-09-27 Agregar maze solver con regla de mano derecha e interfaz web
2026-09-29 Unificar diagnostico, PID de pared y maze solver en una interfaz
2026-09-29 Documentar sistema unificado de pruebas
2026-09-29 Mover test suite a carpeta de sketch compatible con Arduino
2026-09-29 Eliminar sketch fuera de carpeta Arduino
2026-09-29 Actualizar ruta del sketch unificado para Arduino
2026-09-30 Mejorar Maze Solver con frenado frontal y giros por encoder
2026-09-30 agrego imagenes y stl
    [AUS_KIM.stl, AUS_KIM_soporteplaqueta.stl, AUS_KIM_top.stl, base_sharp.stl]
2026-09-30 Actualizar interfaz Maze para giros por encoder
2026-09-30 Fijar PWM minimo autonomo de AUS_KIM en 155
2026-10-01 Agregar pestaña de calibracion de encoders
2026-10-01 Asegurar modo de calibracion de encoders
2026-10-01 Actualizar calibracion de movimiento AUS_KIM
2026-10-01 Ajustar inicio de frenado frontal a ADC 1900
2026-10-01 Ajustar stop frontal y PWM final de giro
2026-10-01 Agregar espera detenida antes de ejecutar giro en Maze
2026-10-01 Guiar giros del Maze por busqueda de pared derecha
2026-10-05 Agregar control recto por encoders e histeresis de paredes
2026-10-05 Simplificar Maze a PID derecho permanente
2026-10-05 Centrar robot entre paredes despues de giro 180
2026-10-05 Quitar encoders de la navegacion Maze
2026-10-05 Rehacer Maze con seguimiento y giros por PID derecho
2026-10-05 Ajustar protecciones de los giros PID
2026-10-05 Limitar PWM y ajustar STOP frontal a ADC 1750
2026-10-05 Ajustar rangos PWM de avance y giro del Maze
2026-10-06 Simplificar Maze a seguimiento derecho y giros basicos por sensores
2026-10-06 Igualar velocidad de giro y avance a PWM 155
2026-10-06 Avanzar 300 ticks antes de girar en apertura derecha
2026-10-06 Centrar apertura derecha por reaparicion de pared a ADC 2300
2026-10-06 Ajustar referencia frontal de centro a ADC 2300
2026-10-06 Implementar giros de 45 grados y captura de pared derecha
2026-10-06 Limpiar referencias obsoletas de la nueva estrategia Maze
2026-10-07 Simplificar Maze a PID derecho con giros izquierdos por encoder
2026-10-07 Ajustar umbral lateral de pared a ADC 2100
2026-10-07 Separar calibracion de giro 90 derecha e izquierda
2026-10-07 Corregir parametros web de giros 90 separados
2026-10-07 Agregar calibracion de giros 45 derecha e izquierda
2026-10-08 Guardar calibracion de giros AUS_KIM
2026-10-08 Retomar PID derecho si falla el giro por encoder
2026-10-08 Centrar 18 cm al perder pared derecha
2026-10-08 Ajustar frontal a 1700 y velocidades configurables
2026-10-08 Usar PWM 185 en avance de centrado de 18 cm
2026-10-08 Implementar secuencia de aperturas laterales a 5 cm
2026-10-08 AUS_KIM3: diagnosticar motivos de detencion en Maze Solver
2026-10-08 AUS_KIM3: ajustar apertura derecha a 500 ms, 3 cm y 300 ms
2026-10-08 AUS_KIM3: equilibrar motores en avances rectos mediante encoders
2026-10-10 AUS_KIM: agregar pantalla de carrera RMP en /race con control de largada
2026-10-10 Agregar generador de firmware de carrera desde Test Suite
2026-10-10 Test Suite: acceso directo a pantalla de carrera RMP
2026-10-10 AUS_KIM3: reintentar busqueda de salida en lugar de detenerse tras dos giros
2026-10-10 Sincronizar rmp_logo.h con el firmware de carrera
2026-10-10 Documentar encabezado RMP y sincronizacion de logo en carrera
2026-10-10 Test Suite RMP: pestañas pared derecha/izquierda para PID y laberinto
2026-10-10 Race Control RMP: dos pestañas de largada por pared derecha e izquierda
2026-10-10 Corregir switch de navegación reversible para compilación C++
2026-10-10 Afinar etiquetas de la interfaz para ambos lados de pared
2026-10-10 Documentar carrera reversible y calibraciones de pared izquierda
2026-10-10 GitHub Actions: sincronizar ambos HTML externos y logo de AUS_KIM
2026-10-10 Documentar separación de HTML, logo y código de control AUS_KIM
2026-10-10 AUS_KIM: reemplazar avance y giros autonomos por tiempos calibrables sin encoders
2026-10-10 Test Suite: calibrar avance y giros por tiempo sin encoders
2026-10-10 Agregar prueba calibrable sin encoders de avance y giros por tiempo
2026-10-10 Test Suite: botones de calibracion avance y 90 grados sin encoders
2026-10-10 UI de pruebas: aclarar tiempos iniciales cortos y calibrables
2026-10-10 Clarificar que avance de apertura ya no mide centimetros
2026-10-10 Documentar modo sin encoders y calibraciones por tiempo
2026-10-10 AUS_KIM: prioridad derecha, frontal ADC1650, apertura ADC1750 y avance objetivo 15cm
2026-10-10 RMP Race: ejecutar siempre estrategia de pared derecha
2026-10-10 Test Suite: parametros visibles para estrategia derecha y avance objetivo 15 cm
2026-10-10 Documentar configuracion vigente de carrera por pared derecha
2026-10-10 Race RMP: largada autonoma sin dependencia de Wi-Fi y aviso de STOP local
2026-10-10 Documentar carrera autonoma sin Wi-Fi, parada local y limites de ejecucion
2026-10-10 Agregar pruebas separadas de curva abierta derecha/izquierda sin encoders
2026-10-10 Documentar nueva estrategia de pared derecha con curvas abiertas calibrables
2026-10-10 Debounce 100ms bajo ADC1300 antes de perder pared derecha y buscarla sin pivotar
2026-10-10 Dejar Maze solamente por pared derecha y preservar PID izquierdo para diagnostico
2026-10-10 Test Suite: mostrar tiempo de perdida continua del sensor derecho
2026-10-10 Documentar nueva deteccion de perdida derecha ADC1300/100ms y curva amplia
2026-10-29 docs: documentar AUS_KIM V2 ESP32-C3 pinout, motores 1500 RPM y sensores
2026-10-29 docs: destacar AUS_KIM V2 y separar firmware historico ESP32-S3
2026-10-29 Agrega firmware V2 (ESP32-C3): diagnostico y calibracion por Wi-Fi
    - AUS_KIM_V2_DIAG: diagnostico por monitor serie (sensores, encoders, motores).
    - AUS_KIM_V2_CALIB: panel Wi-Fi para calibrar cuentas/mm y separacion de ruedas,
    y probar avance y giros controlados por encoders.
    - Sin probar en la placa. Verificado solo con compilacion en PC con cabeceras
    simuladas y un simulador de movimiento.
    Claude-Session: https://claude.ai/code/session_01Add55kPPfAzs3pFNYLpzJD
2026-10-29 Unifica AUS_KIM_V2_CALIB en un solo .ino
    - Incluye la pagina web dentro del .ino; elimina web_calib.h.
    - Elimina AUS_KIM_V2_DIAG, reemplazado por el panel Wi-Fi.
    - No se toca AUS_KIM_V2_WIFI_CAL (otra version, sin revisar).
    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
2026-10-29 Corrige errores de compilacion de AUS_KIM_V2_CALIB en Arduino
    - Mueve las definiciones de tipos (Encoder, MotionMode, Motion, LastResult)
    antes de la primera funcion: los prototipos que genera Arduino fallaban
    con "'Encoder' was not declared".
    - Quita el argumento por defecto de f(): quedaba duplicado en el prototipo.
    - La pagina web pasa de texto crudo R"HTML(...)" a literales normales, para
    no depender del manejo de raw strings del preprocesador de Arduino.
    La pagina resultante es identica byte a byte a la anterior.
    Verificado solo en PC (cabeceras simuladas, prototipos imitados y simulador
    de movimiento); sin compilar con el toolchain real de ESP32 ni probar en placa.
    Co-Authore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
2026-10-29 Separa la pagina web de AUS_KIM_V2_CALIB en web_calib.h
    La logica queda en el .ino y la parte visual (HTML/CSS/JS) en web_calib.h,
    en la misma carpeta. La pagina es identica byte a byte a la version que
    compilo correctamente. Verificado en PC (prototipos imitados + simulador);
    sin compilar con el toolchain real ni probar en placa tras esta separacion.
    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
2026-10-29 Agrega plantilla (stencil) para ubicar el robot en el centro de la celda
    - tools/generar_plantilla_celda.py: genera el dibujo a partir de los STL del robot.
    - cad/PLANTILLA_CELDA.dxf: dibujo 2D en mm para importar en Fusion
    (capas CORTE, GRABADO y REFERENCIA).
    - cad/PLANTILLA_CELDA_vista.png: vista previa con el robot dentro.
    Supuestos a verificar en el robot y la pista reales: eje de ruedas en z=0 del
    STL, ancho libre del pasillo 238 mm (paredes de 12 mm) y que ninguna pieza
    sobresalga del contorno de los STL.
    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
2026-10-30 Enlazar la ficha técnica en el sitio de RMP Robotics
    Claude-Session: https://claude.ai/code/session_01Add55h1noW2UDnTMLgEgbK
2026-10-30 Página propia del robot con la estética de RMP Robotics
    Vitrina por sistemas e informe técnico, generados desde
    srampello/RMP (tools/web/build_site.py). No editar index.html a mano.
    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
2026-10-30 Ajustar el tamaño del título para nombres largos
    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
2026-10-31 AUS_KIM_V2_CALIB: pestanas Motores y Sensores
    - Pestana Sensores: lectura en vivo de los 3 Sharp y del QRE, umbral de pared
    por sensor (valor escrito o "usar valor actual") con histeresis, deteccion
    de piso blanco/negro con captura de ambos valores, estado del boton START y
    registro de lecturas por distancia (solo en la pagina).
    - Pestana Motores: sin cambios de logica; presets de celda de 180 y 250 mm.
    - Al cambiar de pestana el robot se detiene.
    - Umbrales y valores del QRE se guardan en la memoria del robot.
    Verificado en PC: compilacion con prototipos imitados, simulador de movimiento
    (sin regresiones), pruebas de sensores con valores simulados, JSON valido y
    pagina cargada en un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
2026-10-31 Eliminar AUS_KIM_V2_WIFI_CAL (duplicado)
    Queda solo AUS_KIM_V2_CALIB, con las pestanas Motores y Sensores.
    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
2026-10-31 Fix: motor izquierdo siempre a maxima velocidad
    GPIO20/21 (IN3/IN4 del motor izquierdo) son RX/TX de la UART0. Con "USB CDC On
    Boot" desactivado, Serial.begin() toma esos pines y deja GPIO21 (TX) en alto,
    por lo que el motor izquierdo giraba siempre a fondo. Ahora Serial solo se usa
    cuando es USB CDC.
    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
2026-10-31 Agregar AUS_KIM_V2_MOTOR_TEST: prueba minima de motores con START
    START: adelante 2 s, pausa, atras 2 s, a velocidad 200. Sin Wi-Fi, Serial ni
    sensores. Otra pulsacion durante la secuencia la detiene.
    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
2026-10-31 Fix compilacion de AUS_KIM_V2_MOTOR_TEST: enum antes de la primera funcion
    El IDE inserta los prototipos antes de la primera funcion, asi que el tipo Fase
    debe estar definido antes.
    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
2026-10-31 MOTOR_TEST: START alterna marcha adelante / parada
    Los dos motores van adelante a velocidad 200 hasta que se vuelve a pulsar START.
    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
2026-11-09 Actualizar la versión de la hoja de estilos compartida
    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
2026-11-10 docs: propuesta AUS_KIM V3 (ESP32-S3-Zero + TB6612FNG)
    Pinout, alimentacion (buck AP63205 soldado), capacitores, conexiones del
    TB6612FNG, Sharp x4, QRE, encoders, START, layout y lista de verificacion.
    Es una propuesta a revisar, no un esquematico terminado.
    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
2026-11-10 docs V3: motores 6 V, angulos de los 4 Sharp, regulador TO-220 (7805)
    - Regulador con huella TO-220 para L7805CV o drop-in conmutado; AP63205 queda
    como alternativa.
    - Tope de PWM en 180 para los N20 de 6 V.
    - Ubicacion y angulos de los Sharp (laterales a 90 grados, frontales paralelos)
    y restriccion del minimo de 4 cm en celdas de 18 cm.
    - Explicacion de PWMA/PWMB a 3,3 V.
    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
2026-11-10 docs V3: PWM en PWMA/PWMB, medicion de bateria y recomendaciones de estabilidad
    PWMA, PWMB y VBAT_SENSE pasan a los pads sueltos 14, 15 y 16 del S3-Zero.
    Modo drive/brake, capacitores en bornes de motor, PWM a 20 kHz, PID de
    velocidad y compensacion por tension de bateria.
    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
2026-11-10 docs V3: PWM a ~31 kHz y misma convencion que los seguidores con TB6612FNG
    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
2026-11-10 Firmware AUS_KIM_V3_CALIB para ESP32-S3-Zero + TB6612FNG
    - Pestanas Motores y Sensores portadas a los pines V3.
    - 4 Sharp (2 laterales + 2 frontales), pared al frente = las dos frontales,
    indicador de alineacion frontal.
    - TB6612FNG: PWM en PWMA/PWMB (31,25 kHz), sentido en IN1/IN2, STBY habilitado
    al final de setup.
    - Lectura de bateria (GPIO3, divisor 100k/47k) y compensacion del PWM para
    motores de 6 V, con calibracion desde la pagina.
    - START pasa a GPIO16 y la bateria a GPIO3 (ADC1, legible con Wi-Fi).
    Verificado en PC: compilacion con prototipos simulados, simulador de motores,
    pruebas de pines/bateria/sensores y pagina en navegador de prueba. Sin
    compilar con el core real ni pr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
2026-11-10 docs V3: diagrama ilustrativo de modulos y componentes
    Imagen (PNG y SVG) con la cadena de alimentacion, ESP32-S3-Zero con su
    pinout, TB6612FNG, motores, Sharp, QRE, START, divisor de bateria y la
    posicion de los sensores. Incluye el generador en tools/.
    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
2026-11-11 docs: diagramas por etapa de la V3 (alimentación, TB6612FNG, motores, Sharp, QRE/START, pines)
    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
